TommyStyrvoky/Volumetric-peristaltic-pump-/Other files/Media/Print orientation.png

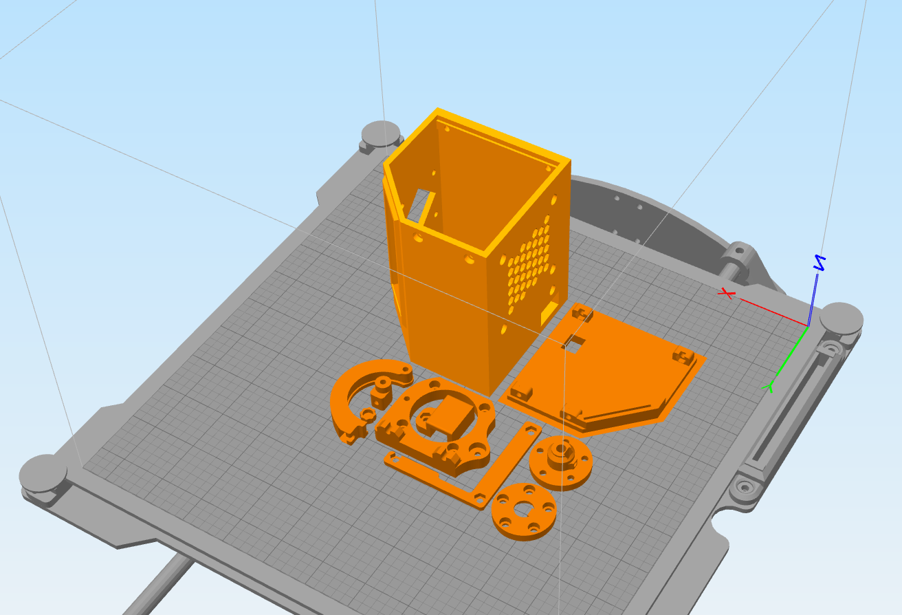
Other files/Media/Print orientation.png
