TommyStyrvoky/Volumetric-peristaltic-pump-/Other files/Media/IMG_0093.jpg

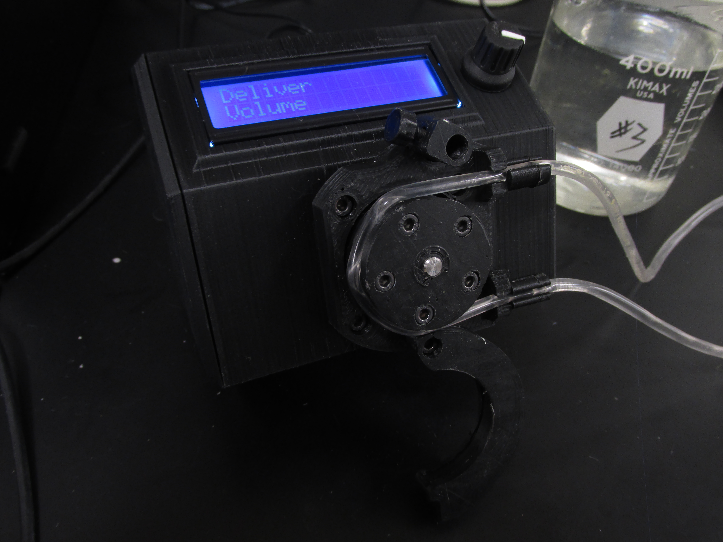
Other files/Media/IMG_0093.jpg
