TommyStyrvoky/Volumetric-peristaltic-pump-/Other files/Media/Accuracy.png

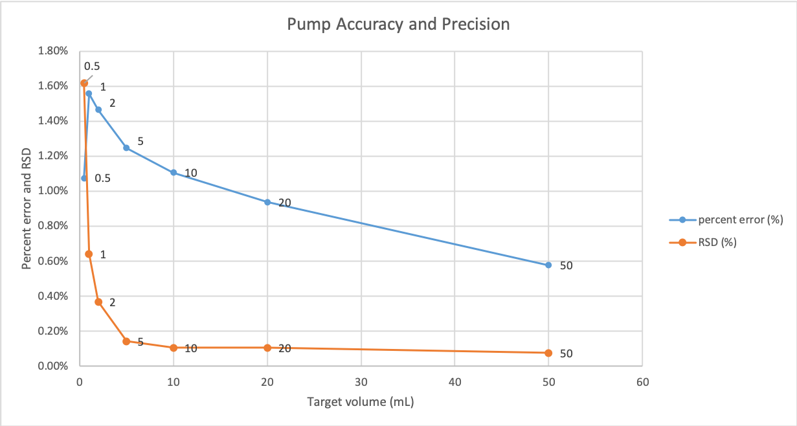
Other files/Media/Accuracy.png
