TommyStyrvoky/Volumetric-peristaltic-pump-/Other files/Media/IMG_0082.jpg

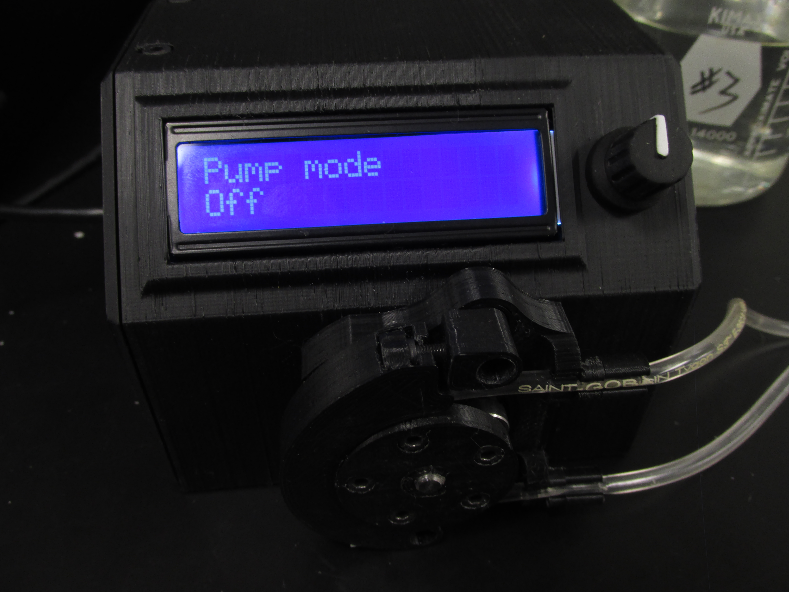
Other files/Media/IMG_0082.jpg
