TommyStyrvoky/Volumetric-peristaltic-pump-/Assembly/Volumetric peristaltic pump BOM.xlsx

Part | quantity | price | quantity used | cost each | part number | retailer | URL
623zz ball bearings | 10 | $8.98 | 5 | $4.49 |  | Amazon | https://www.amazon.com/uxcell-3mmx10mmx4mm-Shielded-Miniature-Bearing/dp/B075CLMYRT?s=industrial
M3*.5mm*10mm Socket head screw | 100 | $5.71 | 15 | $0.86 |  | Amazon | https://www.amazon.com/100Pcs-M3x10-Socket-Screws-Machine/dp/B01EYQ1SBK
LCD | 1 | $9.95 | 1 | $9.95 | 1528-1502-ND | Adafruit | https://www.adafruit.com/product/181
Rotary encoder | 1 | $4.50 | 1 | $4.50 | 1528-2438-ND | Adafruit | https://www.adafruit.com/product/377
AC/DC WALL MOUNT ADAPTER 12V 24W | 1 | $11.56 | 1 | $11.56 | 993-1342-ND | DIgi-Key | https://www.digikey.com/product-detail/en/phihong-usa/PSAC24A-120L6/993-1342-ND/5418494
Arduino Nano | 1 | $22.00 | 1 | $22.00 | 1050-1001-ND | DIgi-Key | https://www.digikey.com/product-detail/en/arduino/A000005/1050-1001-ND/2638989
Power Barrel Connector Jack 2.10mm | 1 | $1.95 | 1 | $1.95 | 1528-2552-ND | Digi-Key | https://www.digikey.com/product-detail/en/adafruit-industries-llc/3642/1528-2552-ND/8346573
STEPPER MOTOR HYBRID BIPOLAR 3V | 1 | $16.95 | 1 | $16.95 | 1568-1106-ND | Digi-Key | https://www.digikey.com/product-detail/en/sparkfun-electronics/ROB-10846/1568-1106-ND/5318748
STEPPER DRIVER 2A 35V LOAD | 1 | $19.95 | 1 | $19.95 | 1568-1066-ND | Digi-Key | https://www.digikey.com/product-detail/en/sparkfun-electronics/ROB-12859/1568-1066-ND/5172292
1Kg Polymaker polylite PLA (black) | 1000.00g | $35.00 | 190.00g | $6.65 | Black, 1Kg reel | Lulzbot | https://www.lulzbot.com/store/filament/polylite-pla
M3*.5mm*8mm Grub screw | 100 | $4.94 | 1 | $0.05 | 91390A101 | Mcmaster Carr | https://www.mcmaster.com/91390A101
M3*.5mm*8mm Socket head screw | 100 | $7.12 | 6 | $0.43 | 91290A113 | Mcmaster Carr | https://www.mcmaster.com/91290a113
M3*.5mm nut | 100 | $2.12 | 21 | $0.45 | 90591A250 | Mcmaster Carr | https://www.mcmaster.com/90591A250
2mm ID, 4mm OD Tygon PVC tubing (25ft) | 25ft | $16.75 | 1.5ft | $1.01 | 5186T11 | Mcmaster Carr | https://www.mcmaster.com/5186t11
200 Ω resistor |  |  | 1
1N4004 diode |  |  | 1
Prefboard 61mm*61mm |  |  | 1
Total |  | $167.48 | 68 Parts | $100.78
