TommyStyrvoky/Volumetric-peristaltic-pump-/Other files/Media/BOM.png

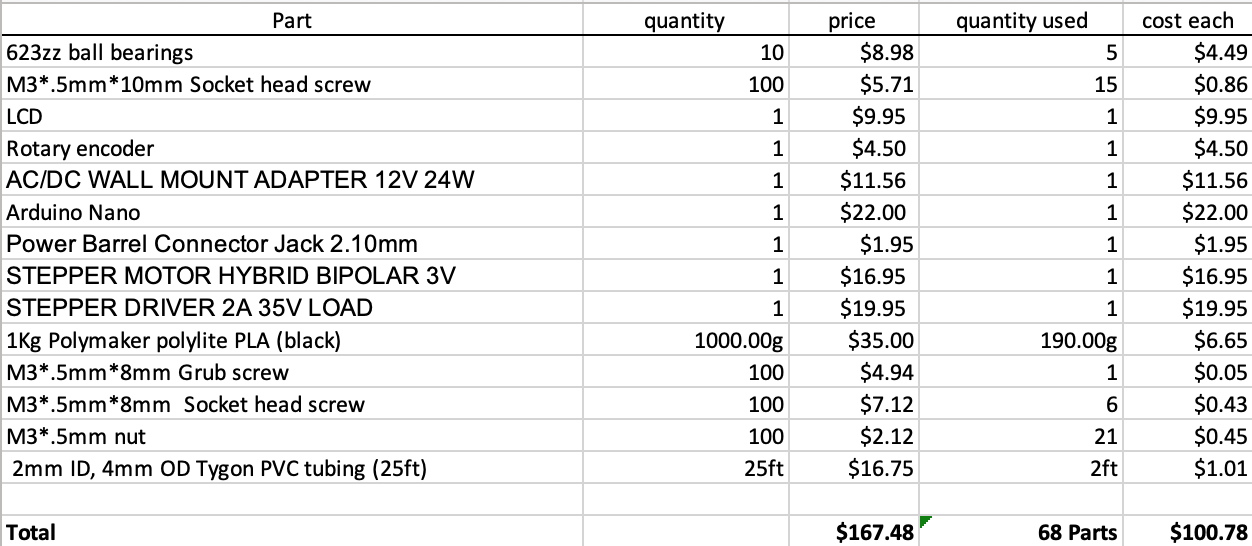
Other files/Media/BOM.png
