TommyStyrvoky/Volumetric-peristaltic-pump-/Peristaltic pump parts/Main fixture.stl

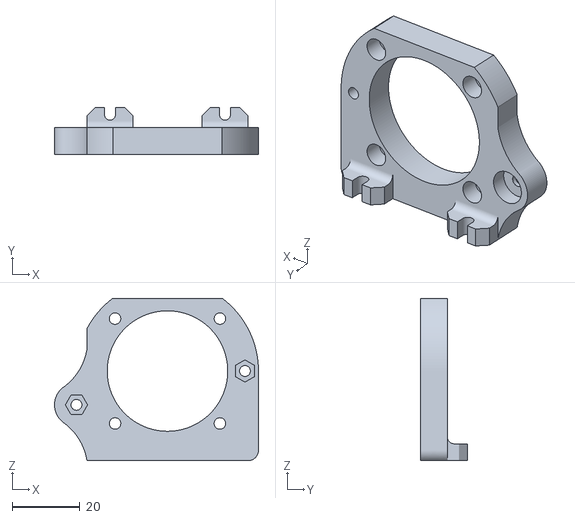
[picture p6: CAD file, 2019-05-18]
Peristaltic pump parts/Main fixture.stl
60.3 x 14.0 x 48.0
