TommyStyrvoky/Volumetric-peristaltic-pump-/Peristaltic pump parts/Micropipette tip adaptor.stl

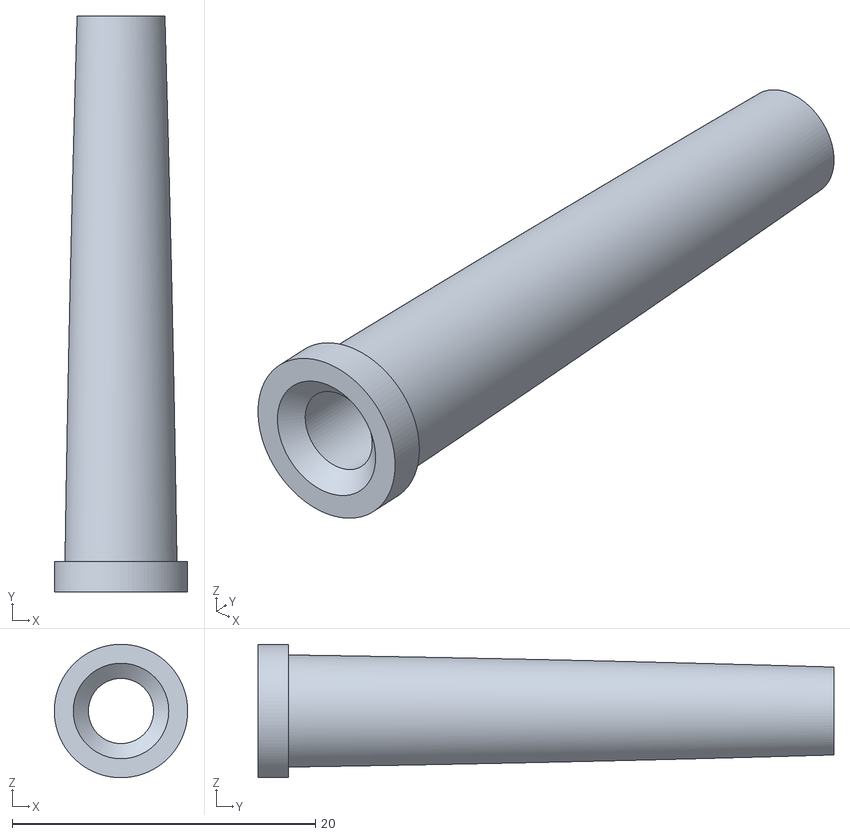
[picture p7: CAD file, 2019-05-18]
Peristaltic pump parts/Micropipette tip adaptor.stl
8.80 x 38.0 x 8.80
