TommyStyrvoky/Volumetric-peristaltic-pump-/Peristaltic pump parts/clamp.stl

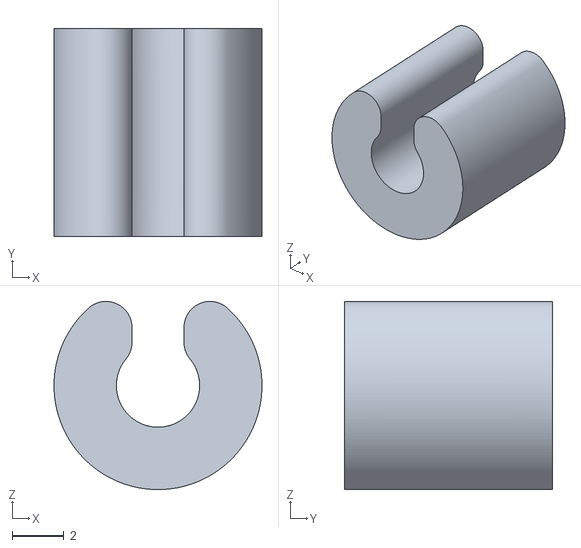
[picture p8: CAD file, 2019-05-18]
Peristaltic pump parts/clamp.stl
8.00 x 8.00 x 7.24
