TommyStyrvoky/Volumetric-peristaltic-pump-/Peristaltic pump parts/Pump Front.stl

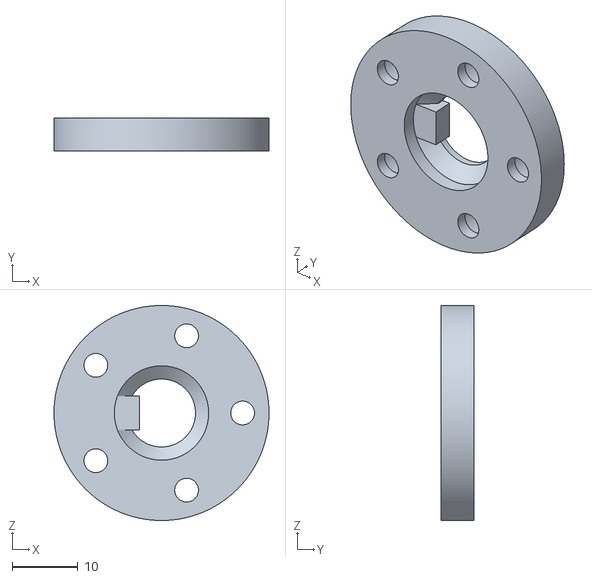
[picture p9: CAD file, 2019-05-18]
Peristaltic pump parts/Pump Front.stl
32.6 x 5.00 x 32.6
