TommyStyrvoky/Volumetric-peristaltic-pump-/Peristaltic pump parts/Knob.stl

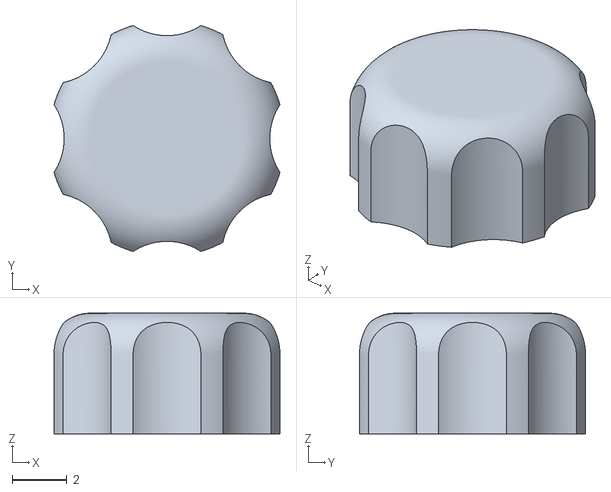
[picture p10: CAD file, 2019-05-18]
Peristaltic pump parts/Knob.stl
8.24 x 8.24 x 4.40
