TommyStyrvoky/Volumetric-peristaltic-pump-/Peristaltic pump parts/Motor housing.stl

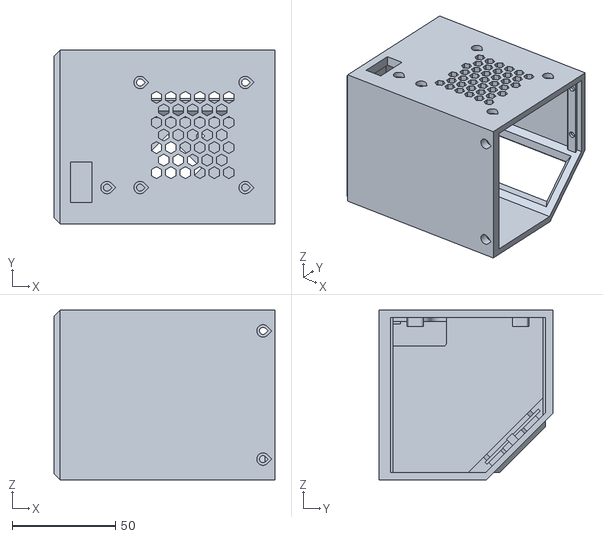
[picture p11: CAD file, 2019-05-18]
Peristaltic pump parts/Motor housing.stl
106.8 x 83.9 x 82.0
