TommyStyrvoky/Volumetric-peristaltic-pump-/Peristaltic pump parts/Board plate.stl

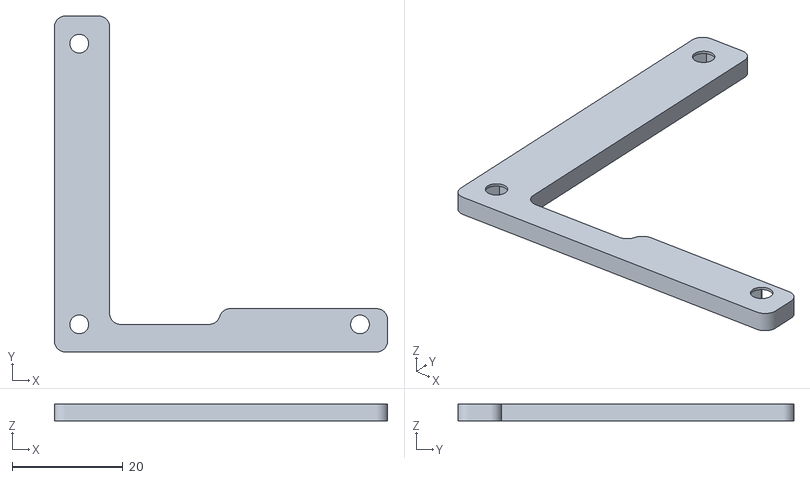
[picture p12: CAD file, 2019-05-18]
Peristaltic pump parts/Board plate.stl
60.3 x 60.8 x 3.00
