TommyStyrvoky/Volumetric-peristaltic-pump-/Peristaltic pump parts/Cover.stl

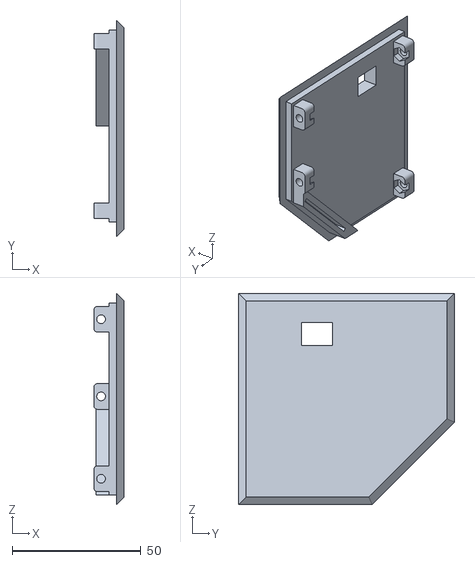
[picture p13: CAD file, 2019-05-18]
Peristaltic pump parts/Cover.stl
11.8 x 83.9 x 82.0
