TommyStyrvoky/Volumetric-peristaltic-pump-/Peristaltic pump parts/Pump Back.stl

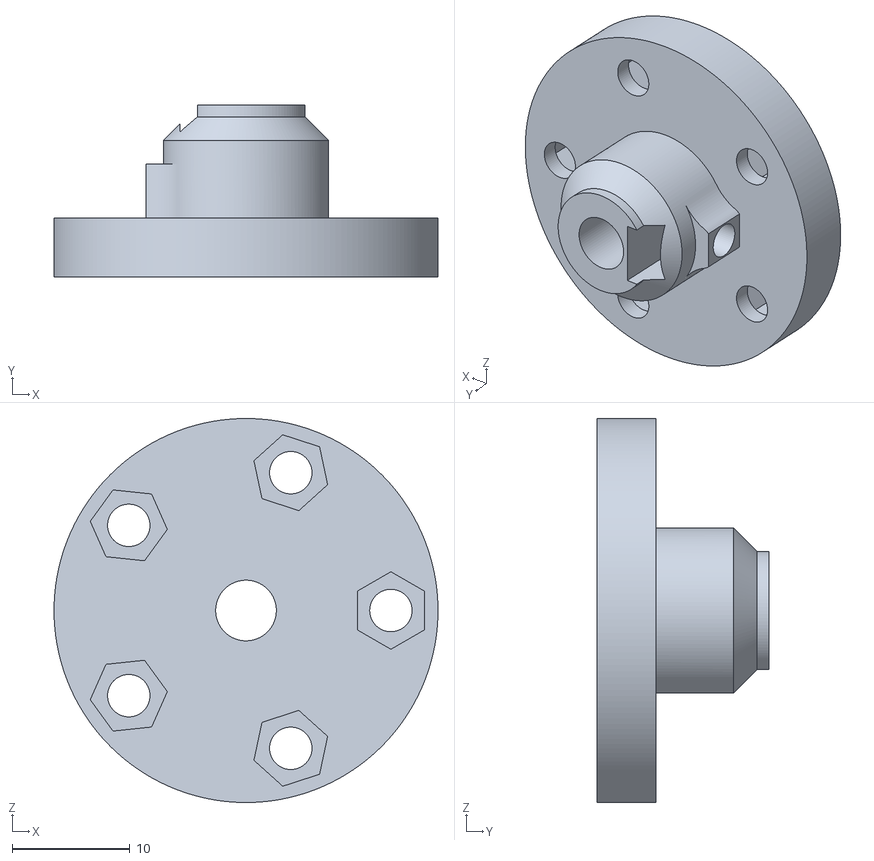
[picture p14: CAD file, 2019-05-18]
Peristaltic pump parts/Pump Back.stl
32.6 x 14.6 x 32.6
