TommyStyrvoky/Volumetric-peristaltic-pump-/Peristaltic pump parts/Tubing clamp.stl

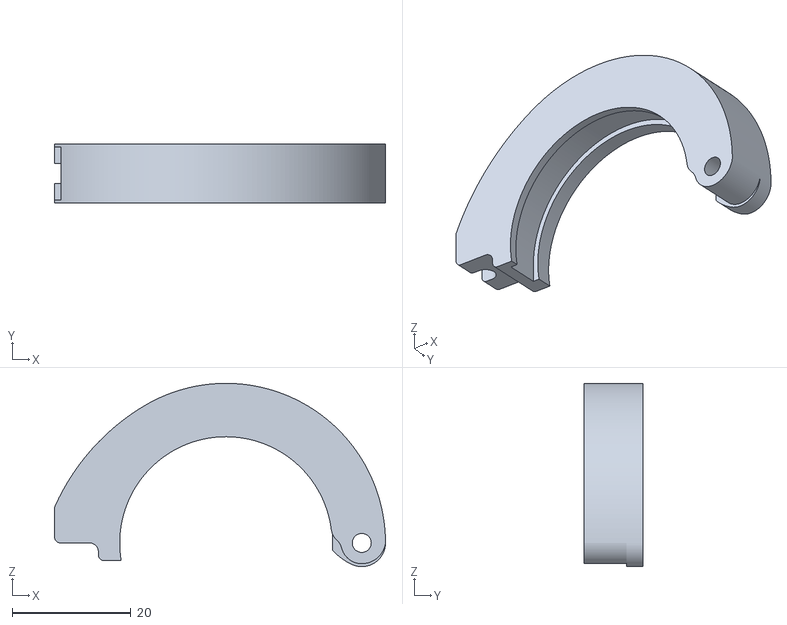
[picture p15: CAD file, 2019-05-18]
Peristaltic pump parts/Tubing clamp.stl
55.8 x 10.0 x 30.9
