TommyStyrvoky/Volumetric-peristaltic-pump-/Peristaltic pump parts/Tensoning fixture.stl

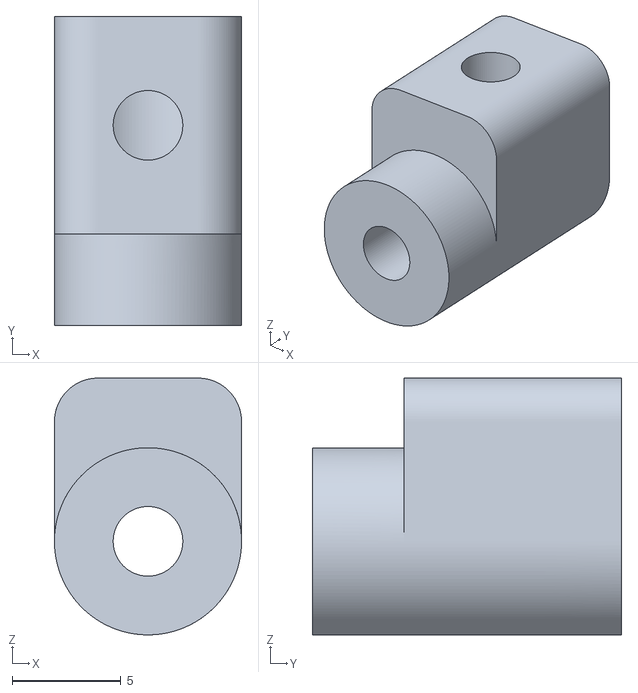
[picture p16: CAD file, 2019-05-18]
Peristaltic pump parts/Tensoning fixture.stl
8.60 x 14.2 x 11.8
