TommyStyrvoky/Volumetric-peristaltic-pump-/Assembly/Wiring schematic.pdf

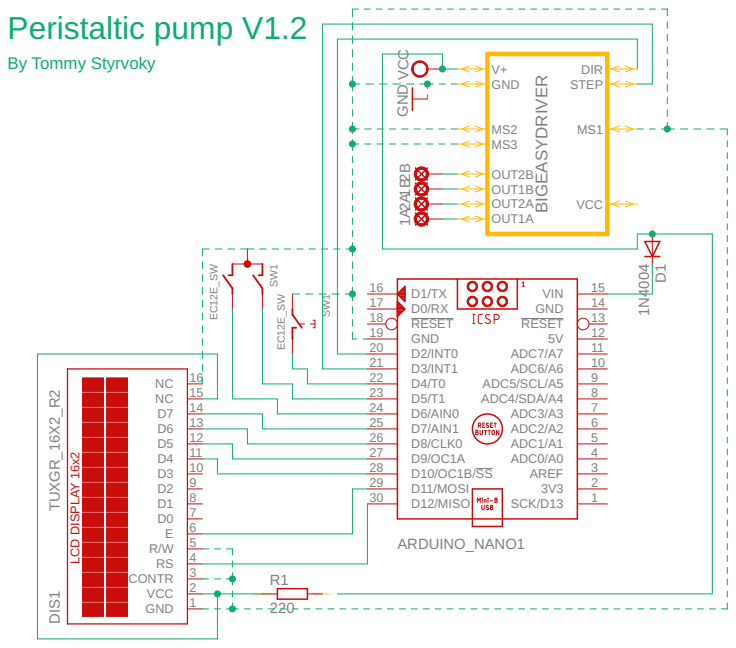
[picture p17: page 1]
