TommyStyrvoky/Volumetric-peristaltic-pump-/(commit log)

2019-04-05 Changed flow settings
2019-04-30 Create Peristaltic Pump Serial interface.vi
2019-05-18 Added 3D printed part files and assembly file
    [Board plate.stl, Cover.stl, Knob.stl, Main fixture.stl, Motor housing.stl, Pump Back.stl, Pump Front.stl, Tensoning fixture.stl]
2019-05-18 Added media
    [Micropipette tip adaptor.stl, Volumetric peristaltic pump BOM.xlsx, pump accuracy.xlsx]
2019-05-18 Added wiring schematic
2019-05-18 Added misc. electronic components
    [Volumetric peristaltic pump BOM.xlsx]
2019-05-18 added print orientation photo
    [Volumetric peristaltic pump BOM.xlsx]
